kh4ng-tayto/stm32-lemon-sorting/docs/hardware/images/conveyor-motor.png

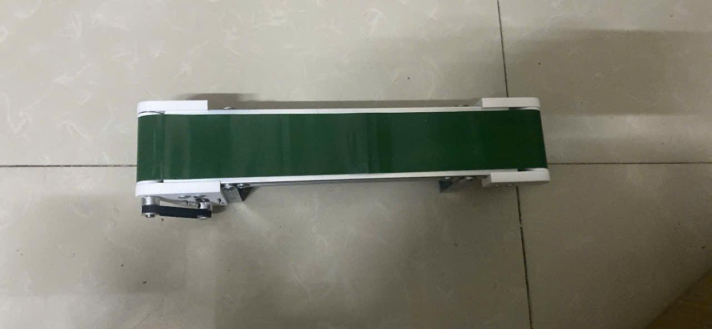
docs/hardware/images/conveyor-motor.png
