kh4ng-tayto/stm32-lemon-sorting/docs/hardware/images/dc-motor-power-controller.png

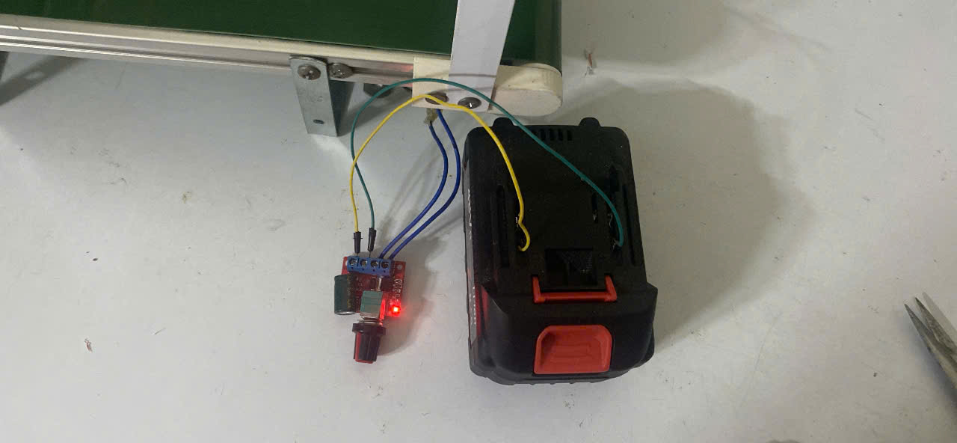
docs/hardware/images/dc-motor-power-controller.png
