kh4ng-tayto/stm32-lemon-sorting/docs/hardware/images/hardware-model-front.png

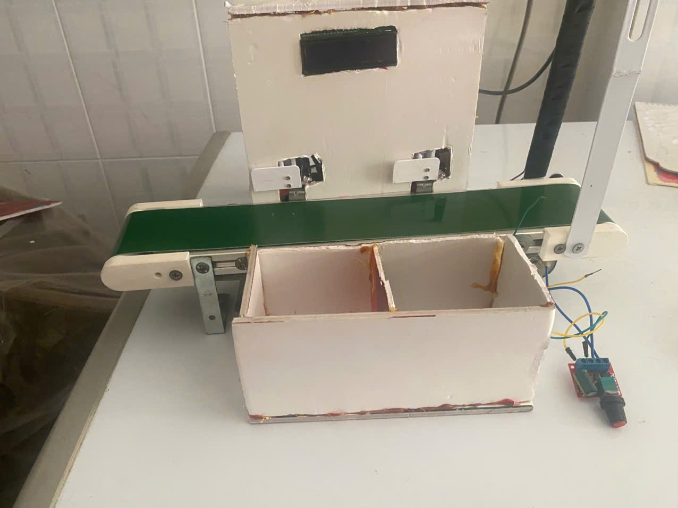
docs/hardware/images/hardware-model-front.png
