kh4ng-tayto/stm32-lemon-sorting/docs/hardware/images/hardware-model-top.png

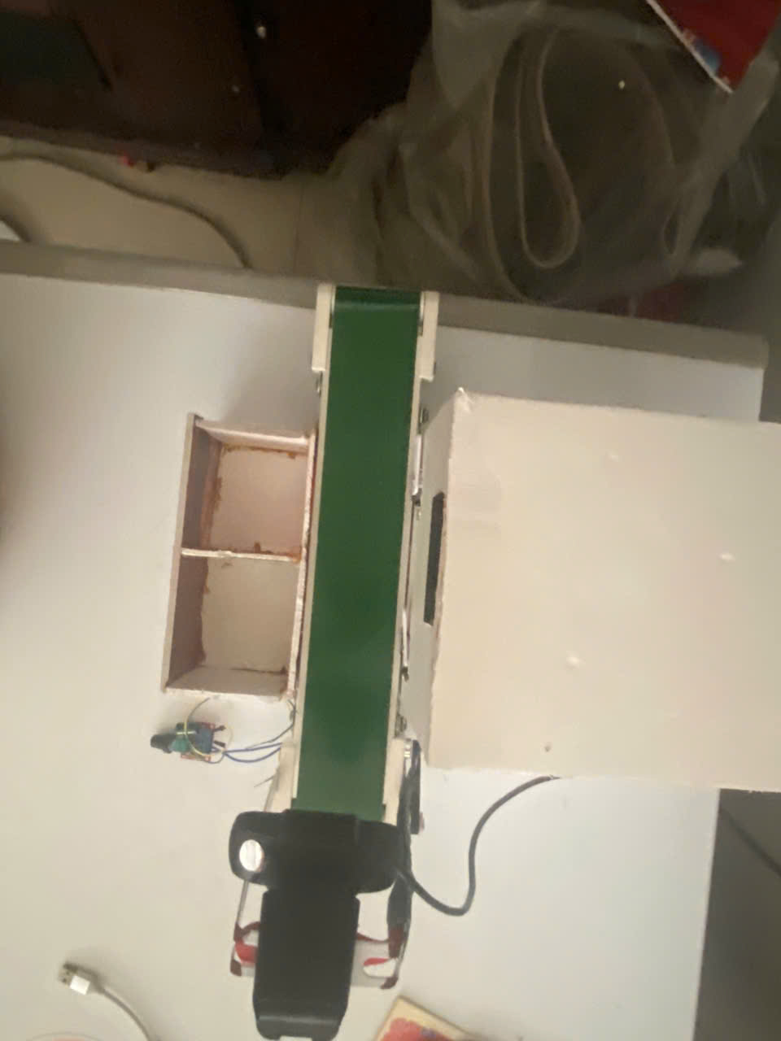
docs/hardware/images/hardware-model-top.png
