kh4ng-tayto/stm32-lemon-sorting/docs/hardware/images/ir-sensor-connection.png

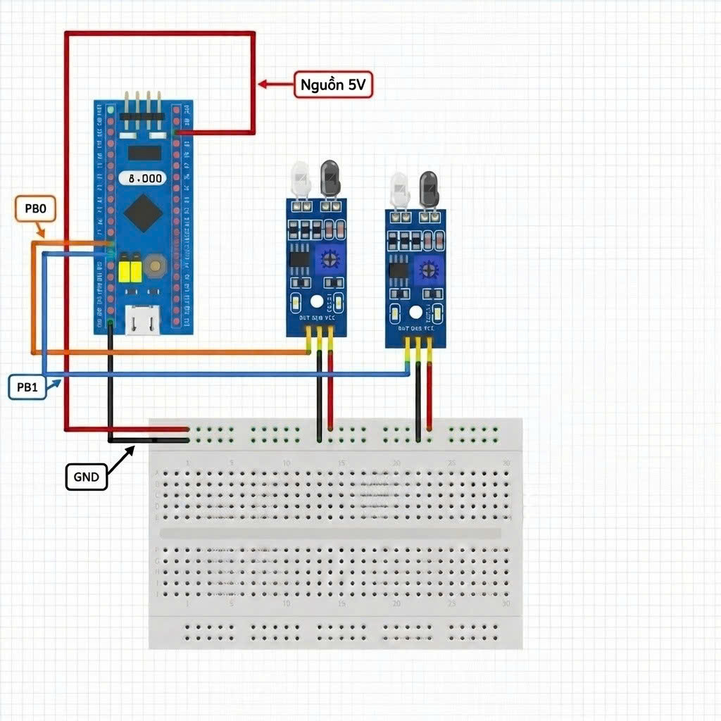
docs/hardware/images/ir-sensor-connection.png
