kh4ng-tayto/stm32-lemon-sorting/docs/hardware/images/makita-battery-source.jpg

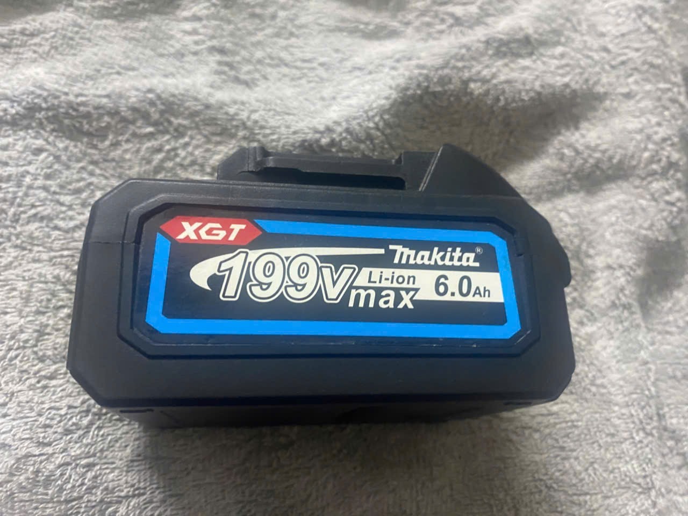
docs/hardware/images/makita-battery-source.jpg
