kh4ng-tayto/stm32-lemon-sorting/docs/hardware/images/pc-ch340-stm32-connection.png

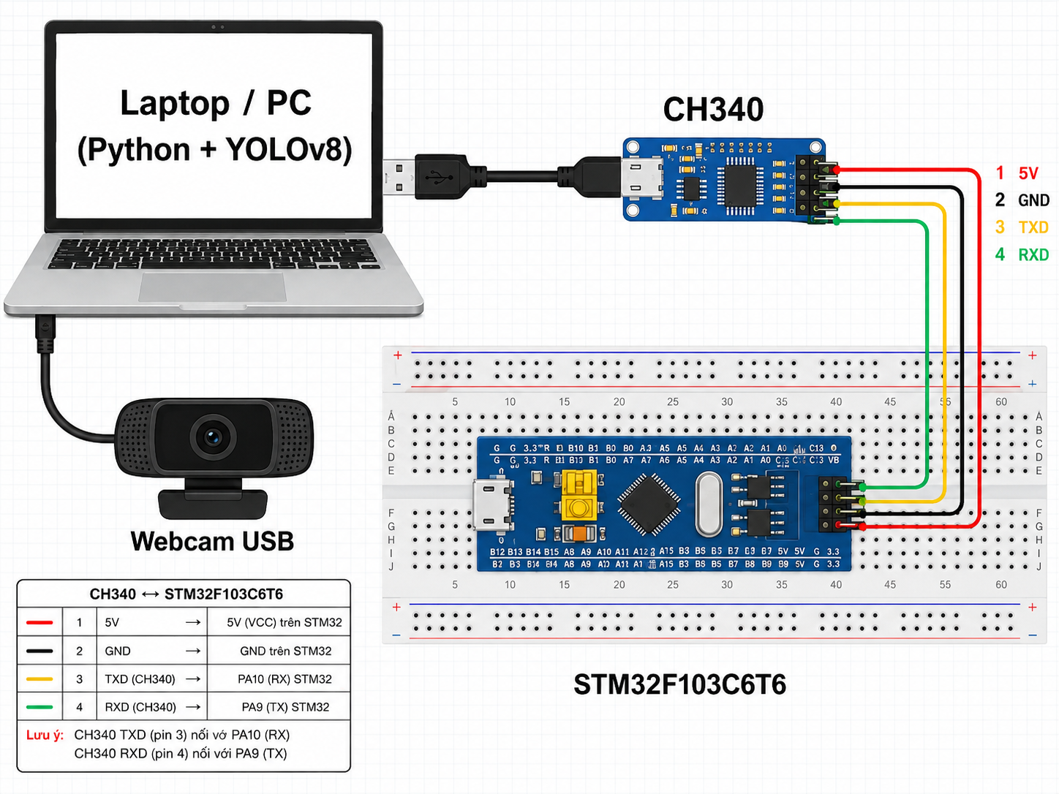
docs/hardware/images/pc-ch340-stm32-connection.png
