kh4ng-tayto/stm32-lemon-sorting/docs/hardware/images/pin makita.jpg

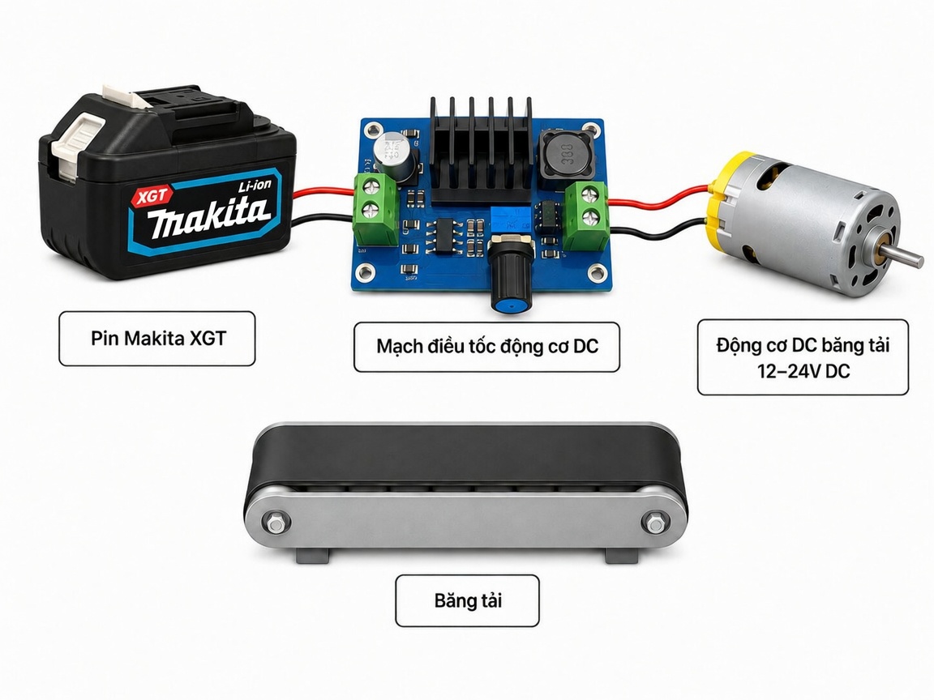
docs/hardware/images/pin makita.jpg
