kh4ng-tayto/stm32-lemon-sorting/docs/hardware/images/product-sorting-bins.jpg

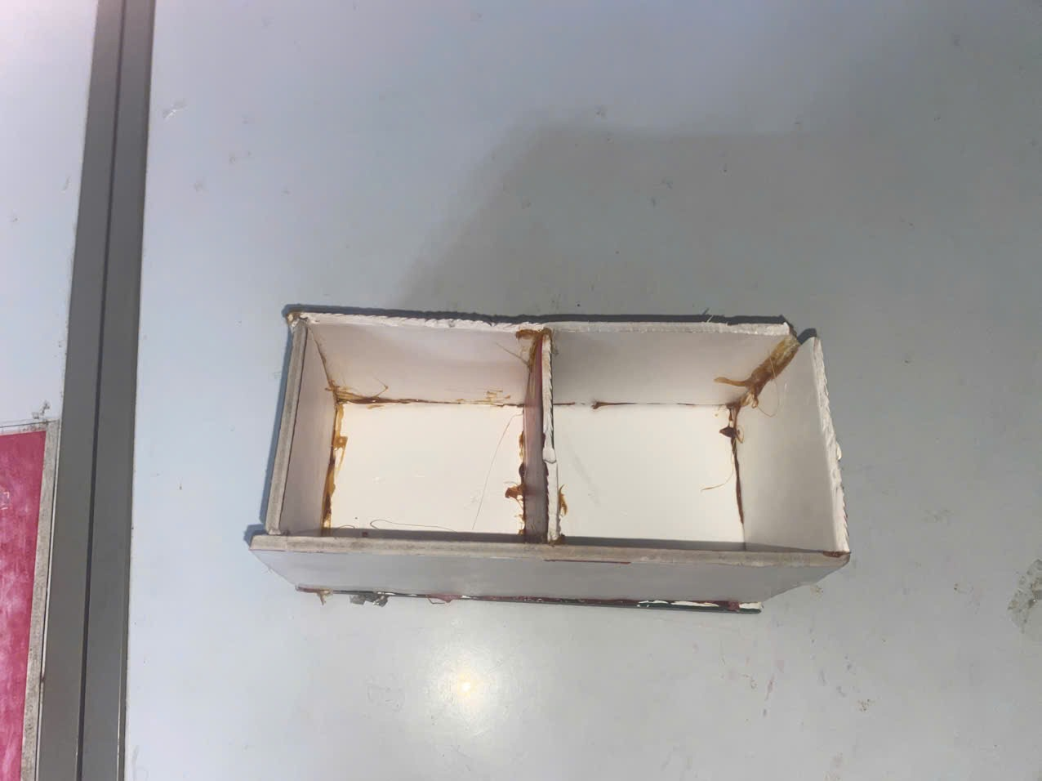
docs/hardware/images/product-sorting-bins.jpg
