kh4ng-tayto/stm32-lemon-sorting/docs/hardware/images/servo-pwm-connection.png

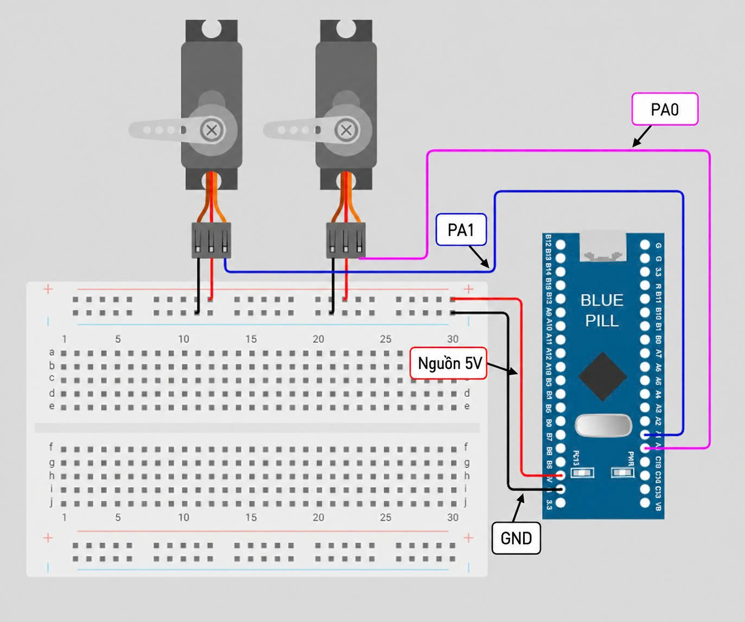
docs/hardware/images/servo-pwm-connection.png
