kh4ng-tayto/stm32-lemon-sorting/docs/hardware/images/servo-sorting-mechanism-1.jpg

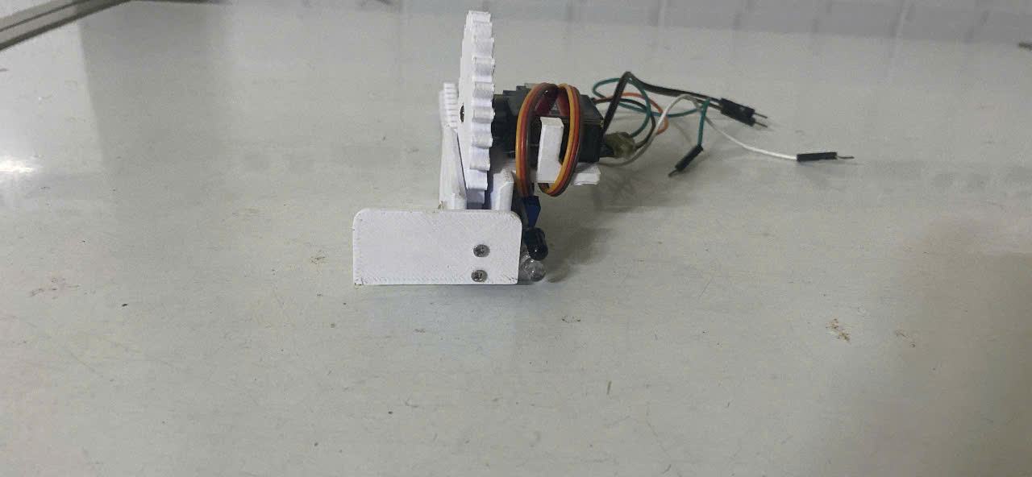
docs/hardware/images/servo-sorting-mechanism-1.jpg
