kh4ng-tayto/stm32-lemon-sorting/docs/hardware/images/servo-sorting-mechanism-2.jpg

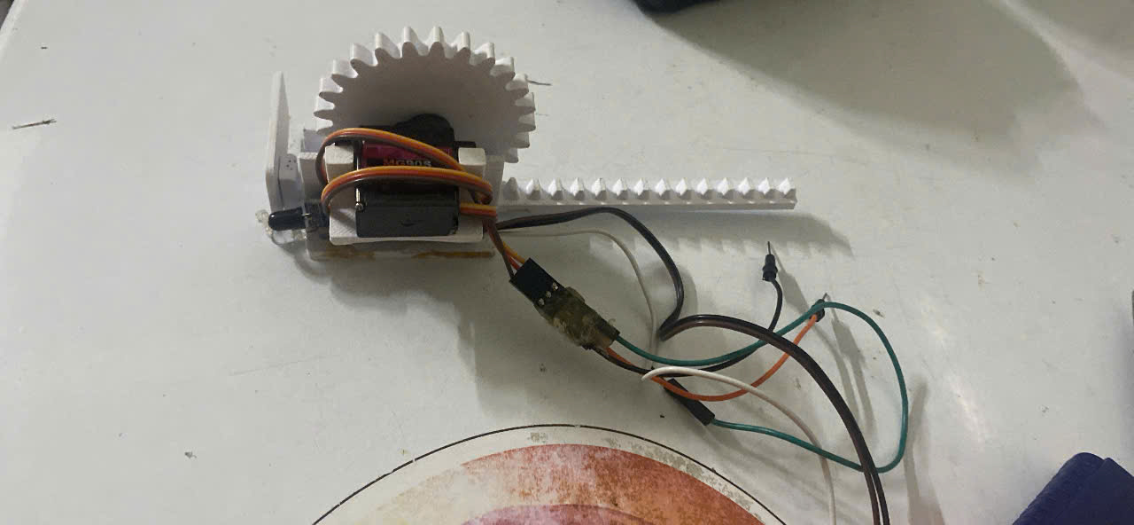
docs/hardware/images/servo-sorting-mechanism-2.jpg
