kh4ng-tayto/stm32-lemon-sorting/docs/hardware/images/st-link-v2-connection.png

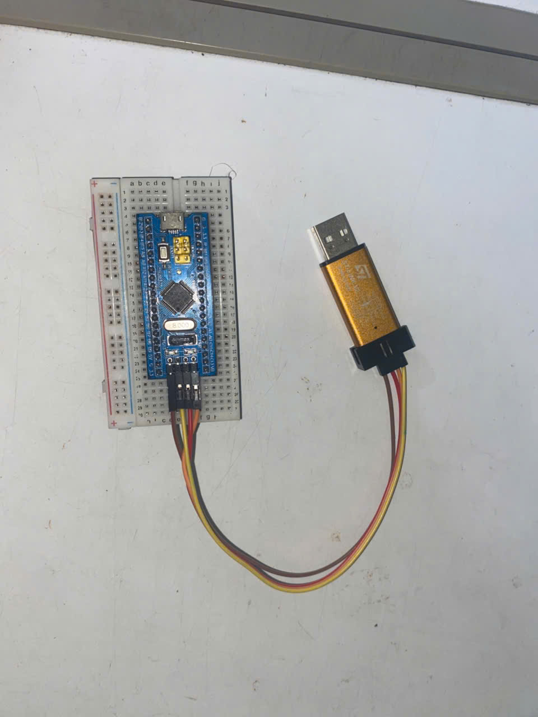
docs/hardware/images/st-link-v2-connection.png
