kh4ng-tayto/stm32-lemon-sorting/docs/hardware/images/usb-to-com-ch340-connection.png

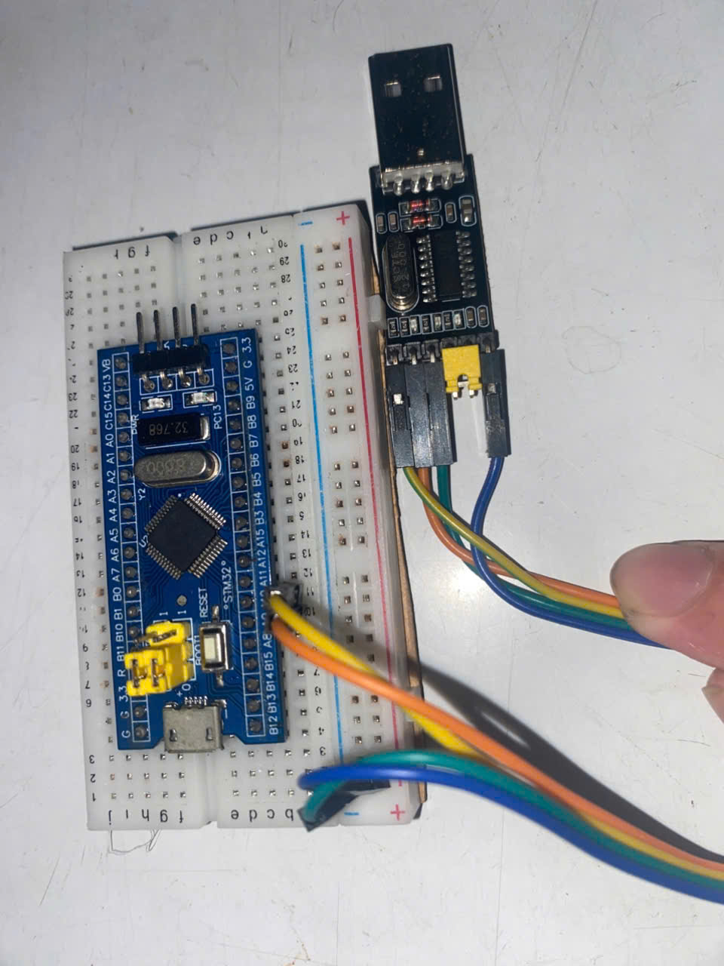
docs/hardware/images/usb-to-com-ch340-connection.png
