kh4ng-tayto/stm32-lemon-sorting/docs/reproducibility/near_duplicate_review.png

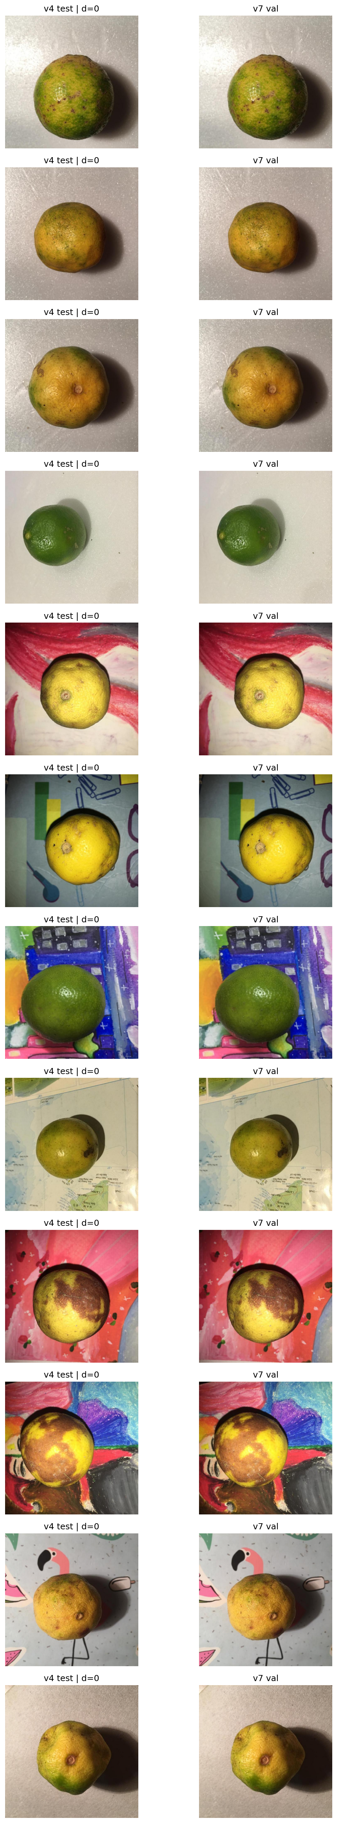
docs/reproducibility/near_duplicate_review.png
