kh4ng-tayto/stm32-lemon-sorting/docs/systems/architecture.png

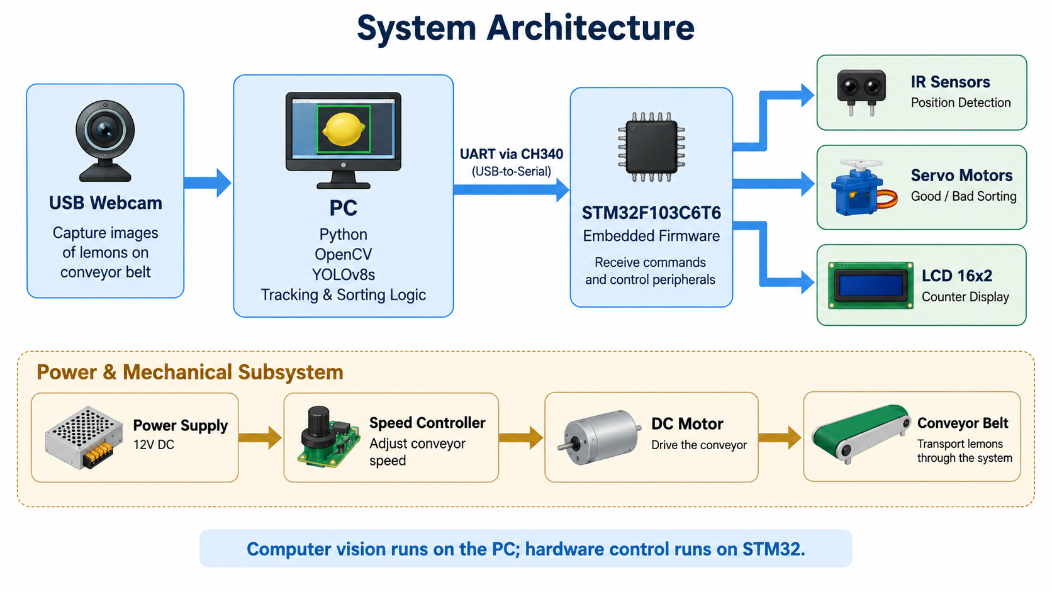
docs/systems/architecture.png
