kh4ng-tayto/stm32-lemon-sorting/docs/systems/system_overview.png

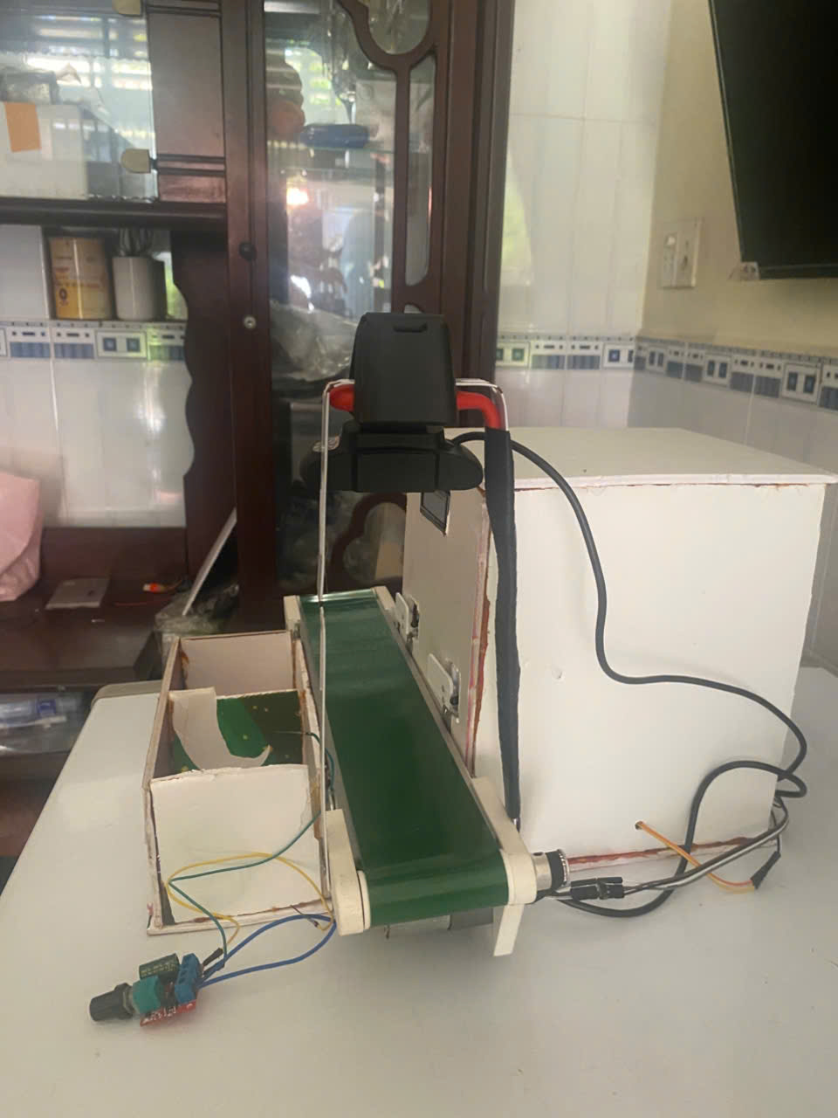
docs/systems/system_overview.png
