kh4ng-tayto/stm32-lemon-sorting/docs/hardware/images/lcd-display-assembly.png

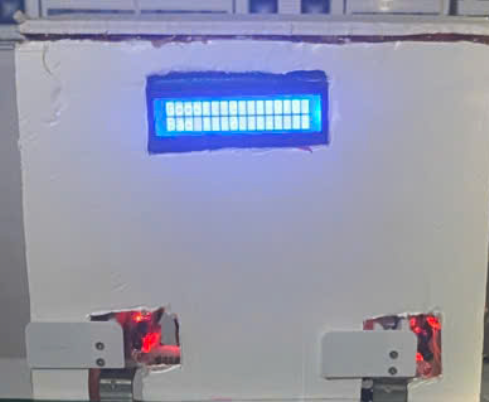
docs/hardware/images/lcd-display-assembly.png
