kh4ng-tayto/stm32-lemon-sorting/docs/hardware/images/lcd-i2c-wiring.png

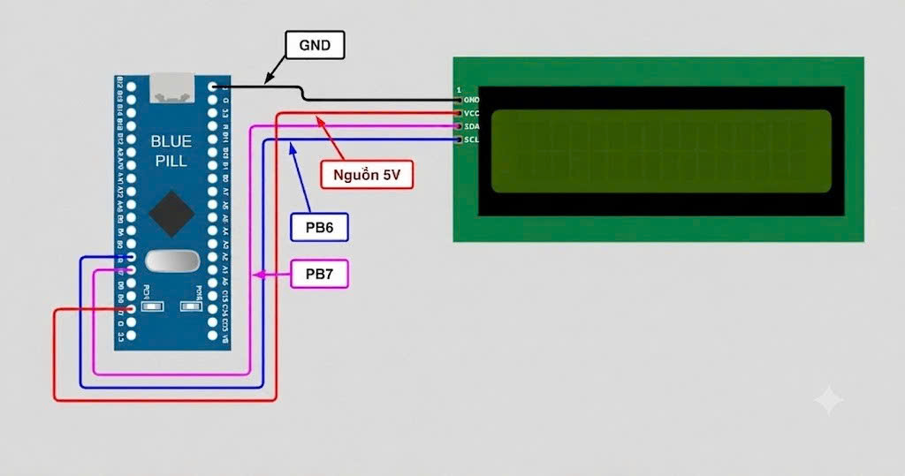
docs/hardware/images/lcd-i2c-wiring.png
