kh4ng-tayto/stm32-lemon-sorting/docs/hardware/images/webcam-conveyor-assembly-updated.png

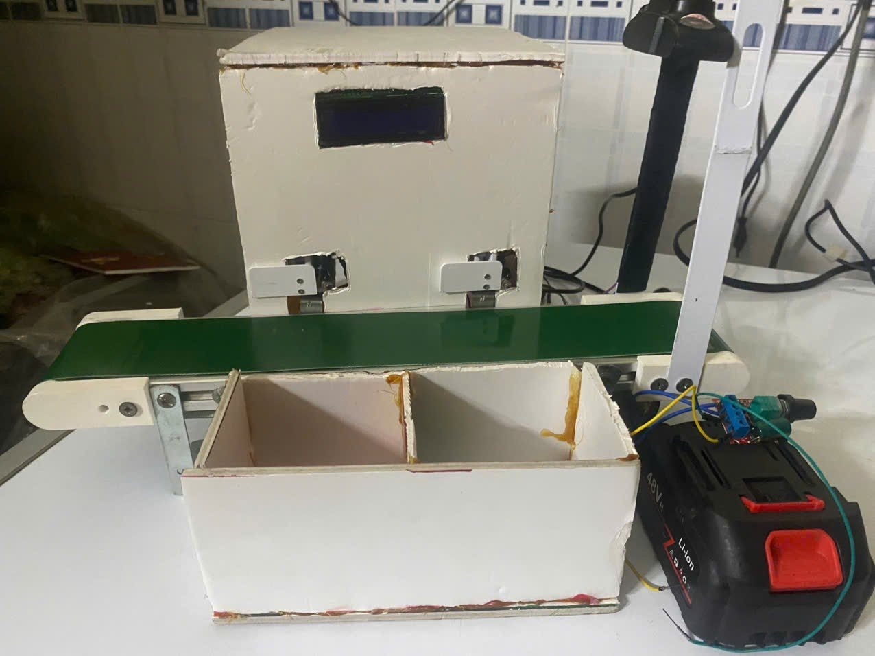
docs/hardware/images/webcam-conveyor-assembly-updated.png
