kh4ng-tayto/stm32-lemon-sorting/docs/training/results.csv

epoch | time | train/box_loss | train/cls_loss | train/dfl_loss | metrics/precision(B) | metrics/recall(B) | metrics/mAP50(B) | metrics/mAP50-95(B) | val/box_loss | val/cls_loss | val/dfl_loss | lr/pg0 | lr/pg1 | lr/pg2
1 | 36.604 | 0.65117 | 0.96157 | 1.0711 | 0.84919 | 0.89818 | 0.93171 | 0.7969 | 0.56903 | 0.96519 | 1.01138 | 0.000551291 | 0.000551291 | 0.000551291
2 | 73.107 | 0.68868 | 0.63311 | 1.07948 | 0.85808 | 0.85598 | 0.89468 | 0.71895 | 0.75815 | 0.91864 | 1.21385 | 0.00109783 | 0.00109783 | 0.00109783
3 | 112.021 | 0.6878 | 0.63172 | 1.06314 | 0.81377 | 0.87582 | 0.90824 | 0.72146 | 0.83851 | 1.16549 | 1.15322 | 0.00163519 | 0.00163519 | 0.00163519
4 | 148.863 | 0.67158 | 0.57028 | 1.04925 | 0.88214 | 0.9143 | 0.94417 | 0.81226 | 0.60301 | 0.75502 | 1.03186 | 0.00162574 | 0.00162574 | 0.00162574
5 | 186.837 | 0.66222 | 0.5468 | 1.04508 | 0.94909 | 0.94123 | 0.98032 | 0.83953 | 0.58128 | 0.51462 | 1.03999 | 0.00161199 | 0.00161199 | 0.00161199
6 | 224.237 | 0.65199 | 0.51172 | 1.0383 | 0.93751 | 0.93441 | 0.97681 | 0.8613 | 0.51969 | 0.47301 | 0.95367 | 0.00159824 | 0.00159824 | 0.00159824
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
