kh4ng-tayto/stm32-lemon-sorting/(commit log)

2026-09-06 Cập nhật README.md với thông tin dataset YOLOv8
    Cập nhật thông tin chi tiết về dataset cho mô hình YOLOv8, bao gồm số lượng ảnh, đối tượng và cách tải dataset từ Roboflow.
2026-09-06 Add wiring diagram for hardware connections
2026-09-06 Create ảnh thật.jpeg
2026-09-06 Rename docs/hardware/pin makita.jpg to docs/hardware/images/pin makita.jpg
2026-11-12 Change baud rate to 9600 in wiring documentation
    Updated baud rate from 115200 to 9600 for consistency.
